RemoKa/DotFlipper/DotFlipper/DotFlipper.pdf

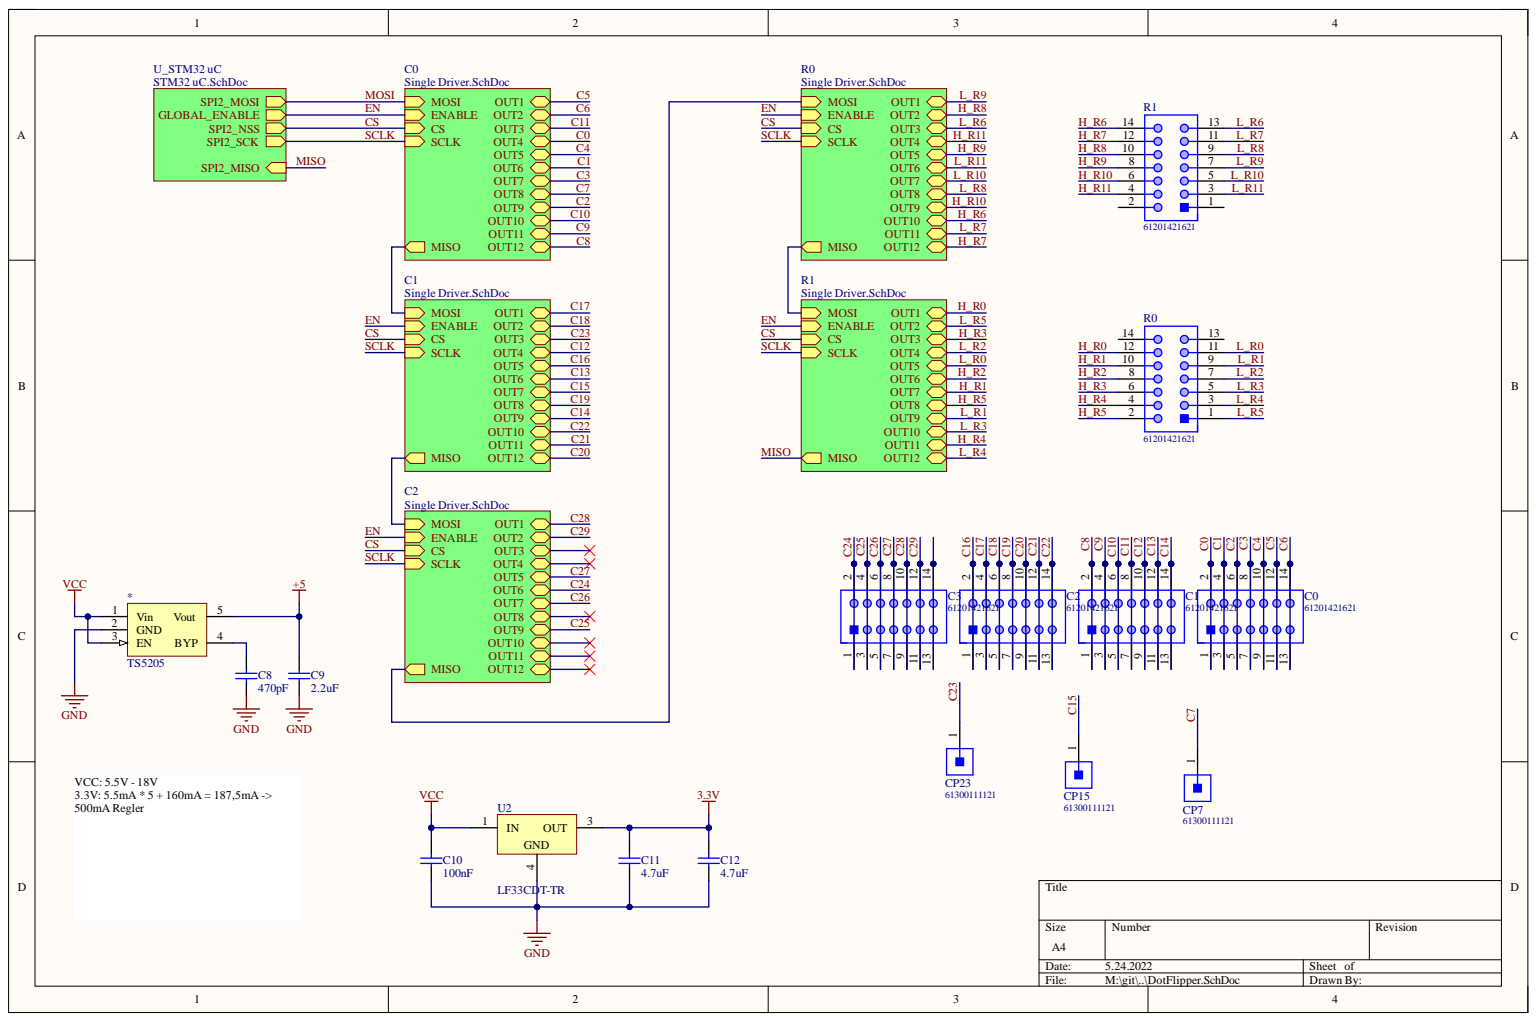
[picture p1: page 1]

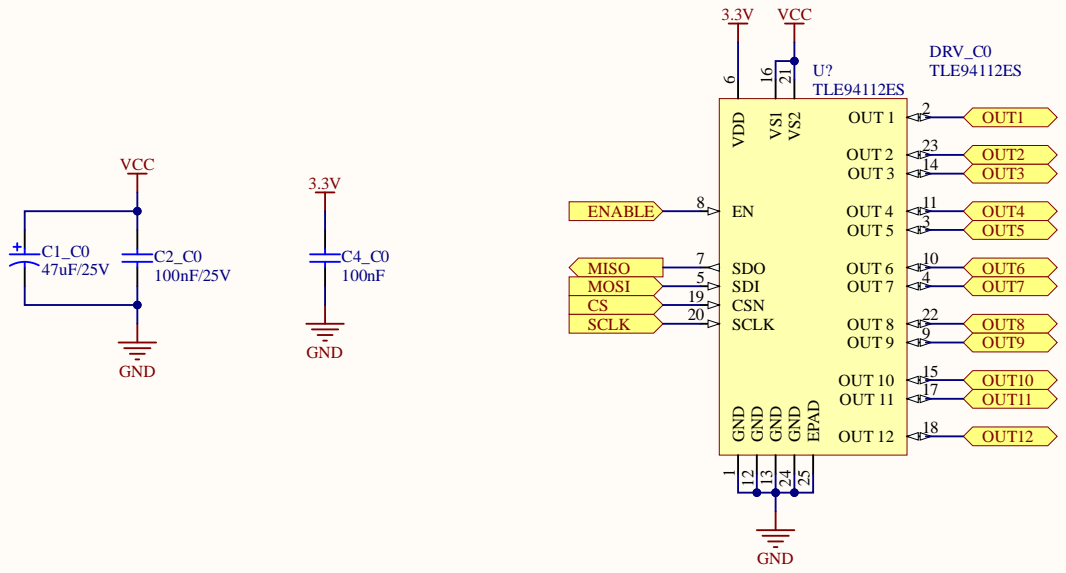
[picture p2: page 2]

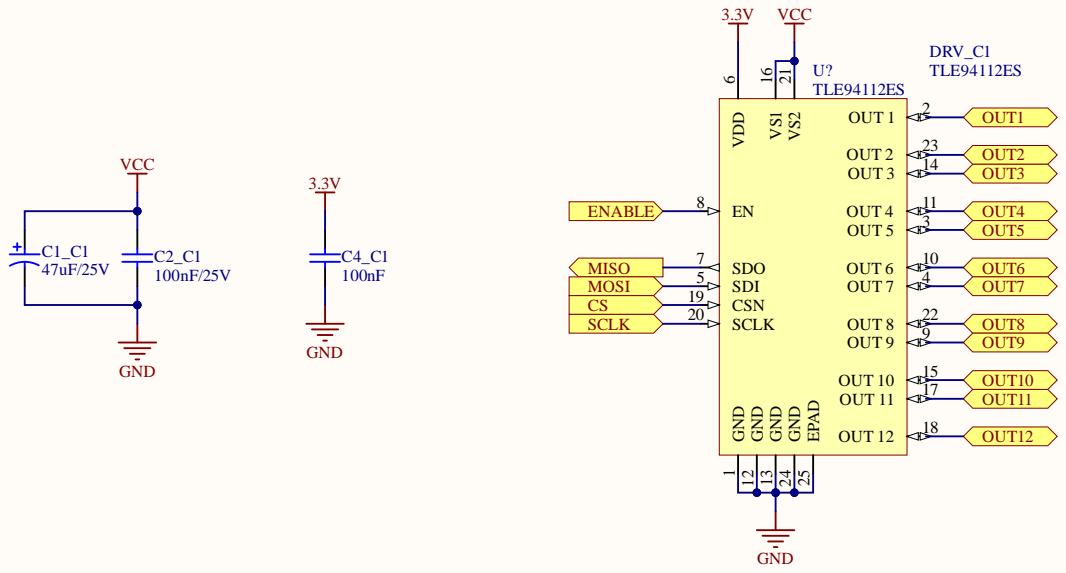
[picture p3: page 3]

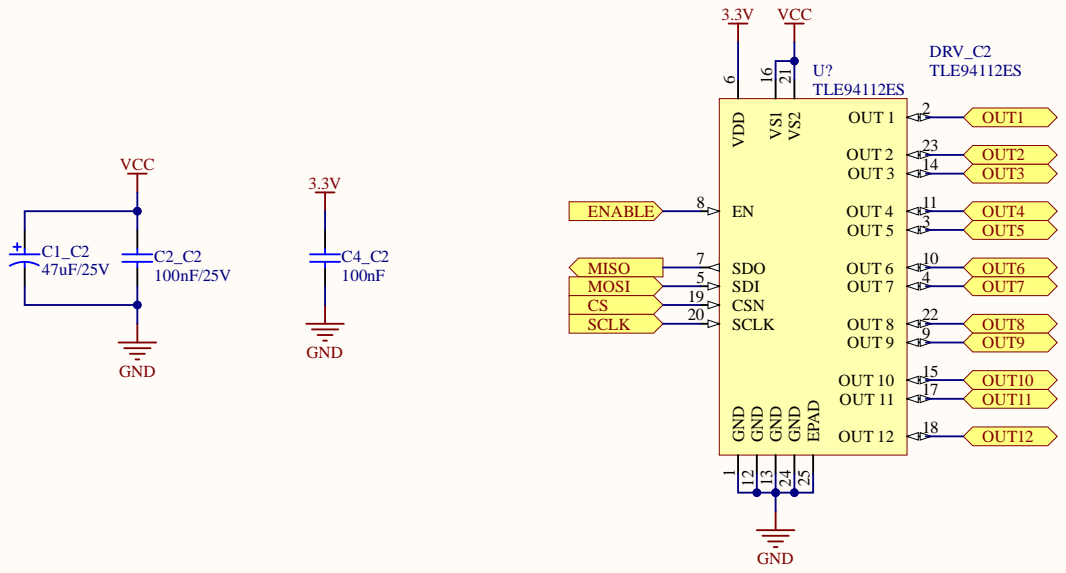
[picture p4: page 4]

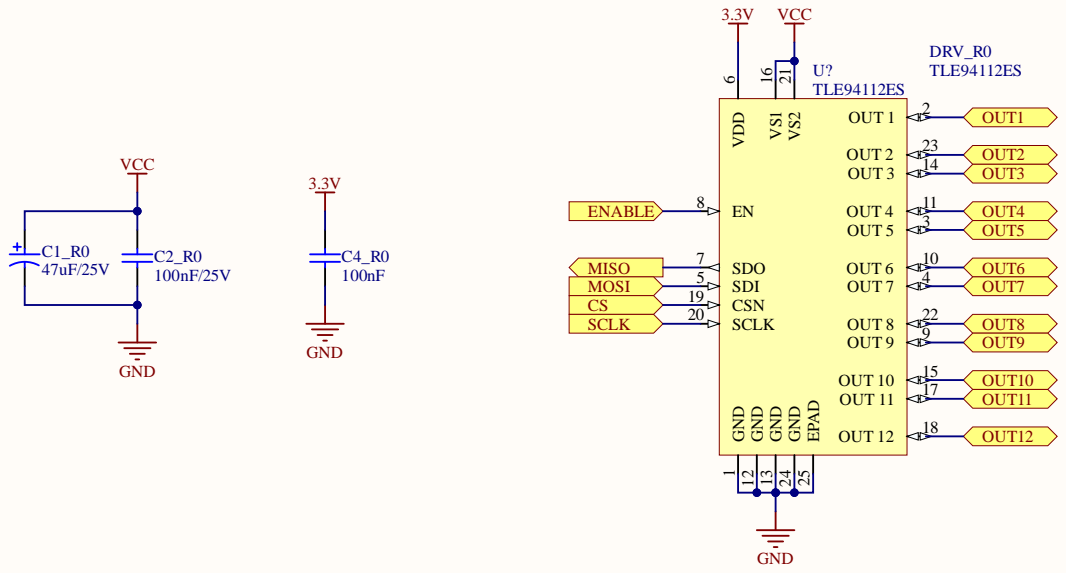
[picture p5: page 5]

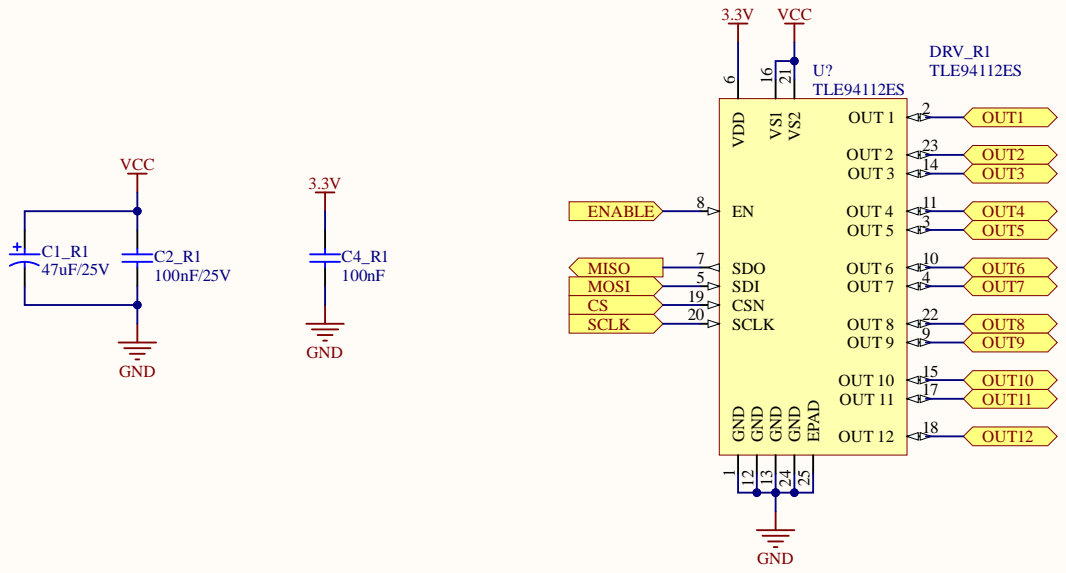
[picture p6: page 6]

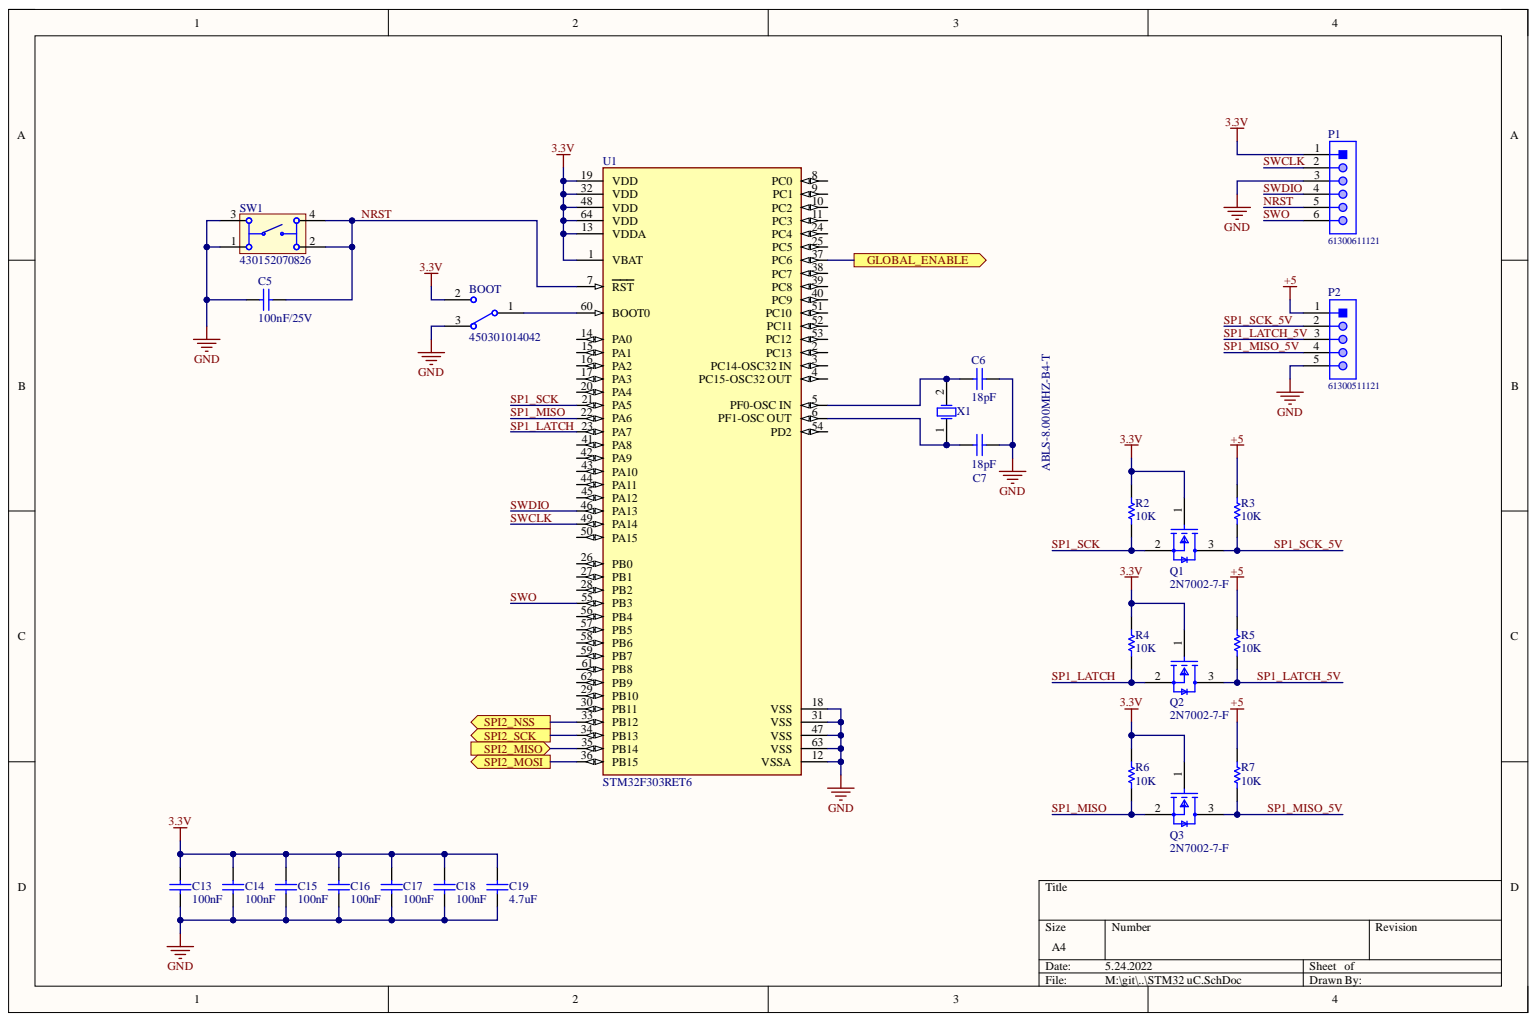
[picture p7: page 7]

4 8 | 1 0
6 4 | 1 1

5 4

3 1
4 7
6 3
1 2

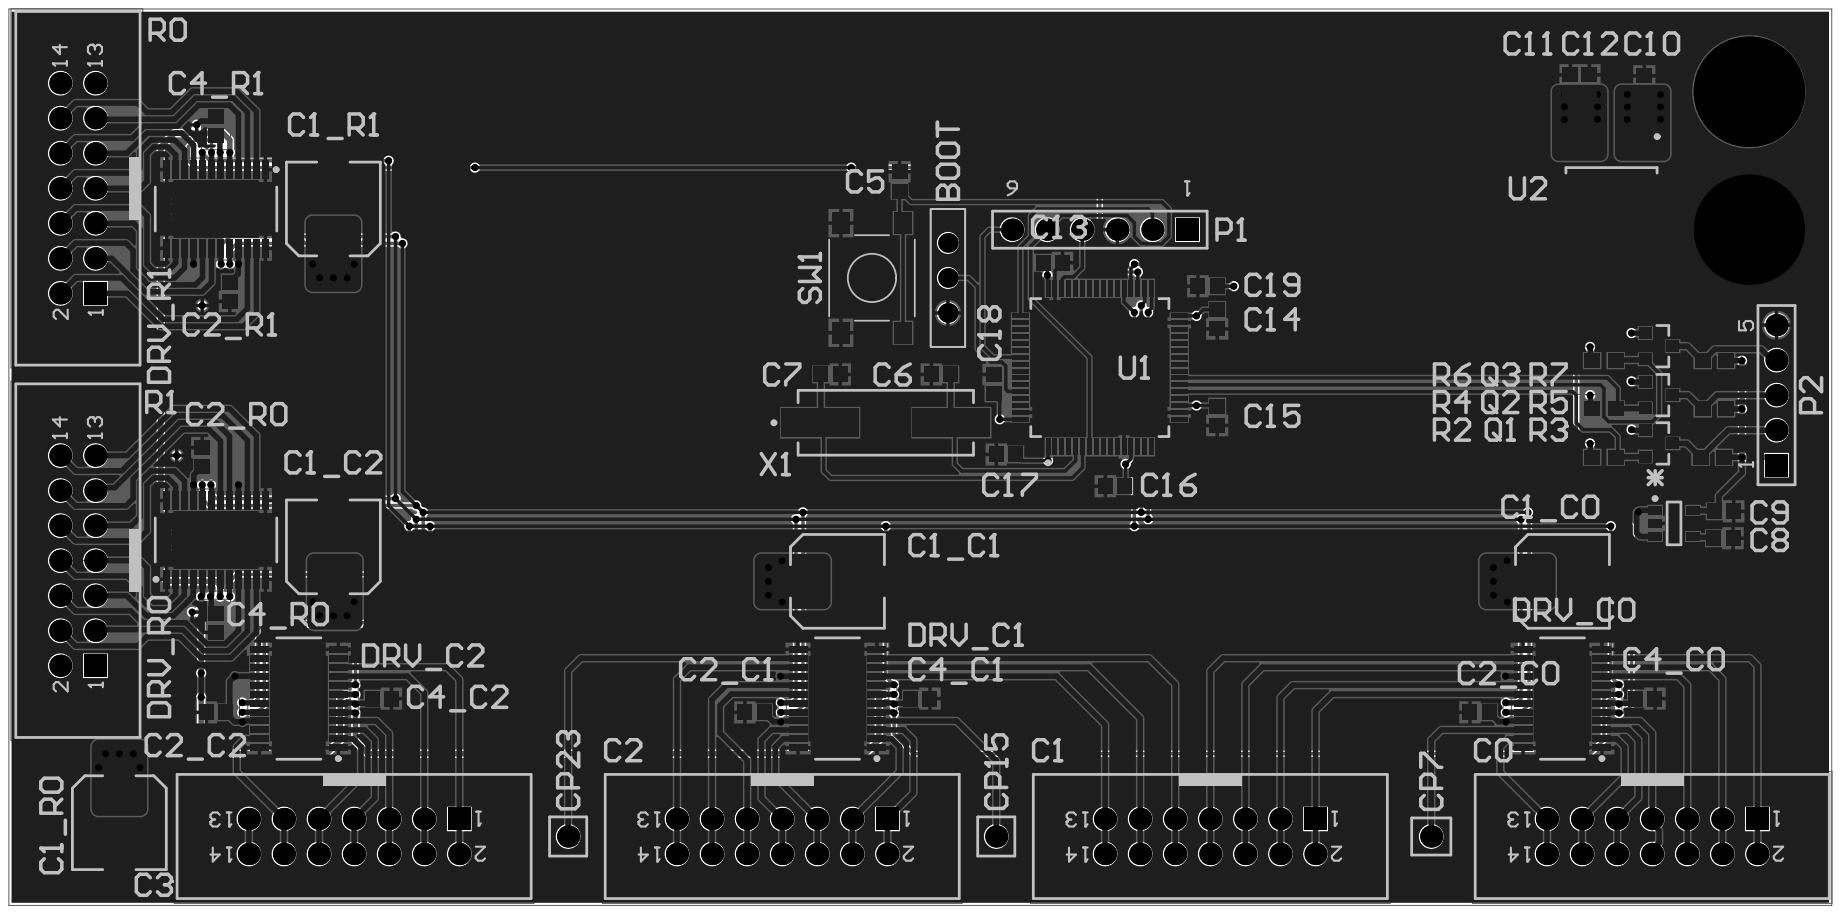
[picture p8: page 8]
