RemoKa/DotFlipper/Documentation/Driver.pdf

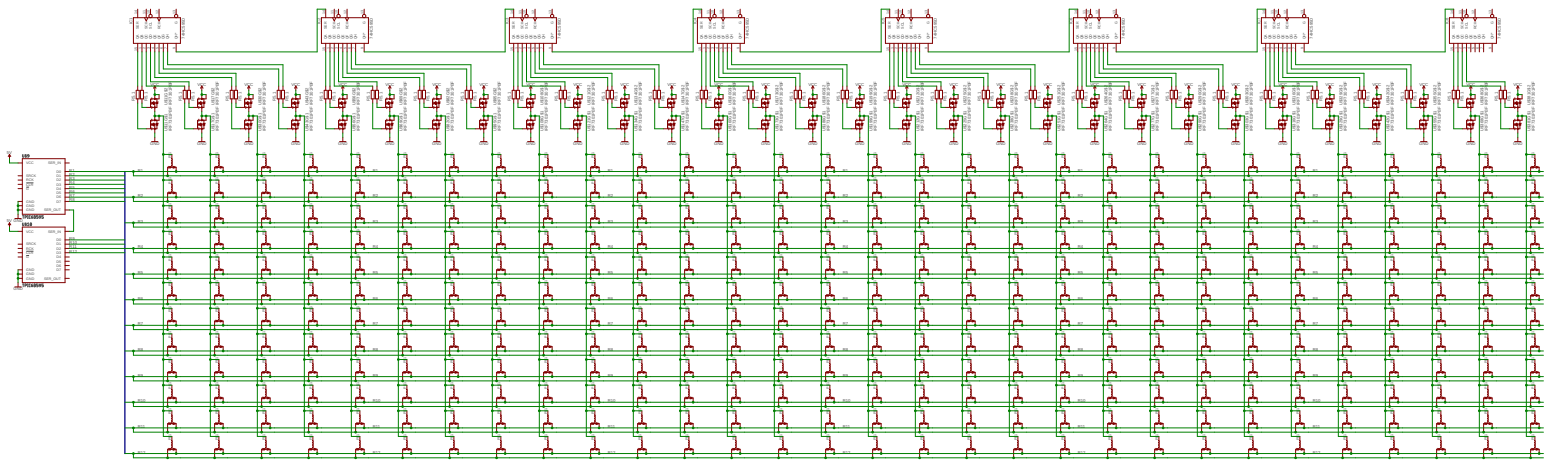
[picture p9: page 1]
