RemoKa/DotFlipper/(list of files, drawings)

Other design files:
DotFlipper/DotFlipper.PrjPcb
DotFlipper/DotFlipper.SchDoc
DotFlipper/PCB/DotFlipper.PcbDoc
DotFlipper/Single Driver.SchDoc
DotFlipper/STM32 uC.SchDoc
