RemoKa/DotFlipper/Firmware/DotFlipper/Core/Src/main.c

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
/* Includes ------------------------------------------------------------------*/
#include "main.h"
#include "spi.h"
#include "gpio.h"

/* USER CODE BEGIN Includes */
#include "TLE94112ES.h"
#include "DISPLAY.h"
/* USER CODE END Includes */

/* USER CODE BEGIN PD */
#define NO_OF_CHIPS	1
#define PULSELENGTH 1000
#define BUFFERLENGHT 12
#define DAISYCHAINLENGHT 5
/* USER CODE END PD */


/* USER CODE BEGIN PV */
int pause = 2000 - PULSELENGTH;
	//uint8_t TXBuf[NO_OF_CHIPS * 2];
	//uint8_t RXBuf[NO_OF_CHIPS * 2];
	//Message Messages[NO_OF_CHIPS];

	//uint8_t controllerData = 0;


///////////////////////////////////
	Display 	display;
	Matrix 		matrix;
	uint32_t 	framebuf1[BUFFERLENGHT];
	uint32_t 	framebuf2[BUFFERLENGHT];
	uint32_t 	difbuf[BUFFERLENGHT];
	Message		messages[DAISYCHAINLENGHT];

/* USER CODE END PV */

void SystemClock_Config(void);
/**
  * @brief  The application entry point.
  * @retval int
  */
int main(void)
{
  /* MCU Configuration--------------------------------------------------------*/

  /* Reset of all peripherals, Initializes the Flash interface and the Systick. */
  HAL_Init();

  /* Configure the system clock */
  SystemClock_Config();

  /* Initialize all configured peripherals */
  MX_GPIO_Init();
  MX_SPI2_Init();
  /* USER CODE BEGIN 2 */
  HAL_GPIO_WritePin(HB_EN_GPIO_Port, HB_EN_Pin, 1);

  matrix.width = 3;
  matrix.height = 2;
  matrix.DaisyChainLength = DAISYCHAINLENGHT;
  matrix.Messages = messages;

  display.width = 30;
  display.height = 12;
  display.Frontbuffer = framebuf1;
  display.Backbuffer = framebuf2;
  display.Differencebuffer = difbuf;
  display.Matrix = matrix;

  /* USER CODE END 2 */

  /* Infinite loop */
  /* USER CODE BEGIN WHILE */
  while (1)
  {
	  /*
	  	  Messages[0].RegisterAdress 	= HB_ACT_3_CTRL;
	  	  Messages[0].Data 				= HB10_HS_EN | HB11_LS_EN;
	  	  Messages[0].WriteClear 		= WRITE;

	  	  TLE94112ES_ConstructTXBuffer(TXBuf, NO_OF_CHIPS, Messages);
	  	  HAL_GPIO_WritePin(SPI2_CS_GPIO_Port, SPI2_CS_Pin, 0);
	  	  HAL_SPI_TransmitReceive(&hspi2, TXBuf, RXBuf, NO_OF_CHIPS * 2, HAL_MAX_DELAY);
	  	  HAL_GPIO_WritePin(SPI2_CS_GPIO_Port, SPI2_CS_Pin, 1);
	  	  TLE94112ES_DeconstructRXBuffer(RXBuf, NO_OF_CHIPS, Messages);

	  	  HAL_Delay(PULSELENGTH);

	  	  Messages[0].RegisterAdress 	= HB_ACT_3_CTRL;
	  	  Messages[0].Data 				= 0x00;
	  	  Messages[0].WriteClear 		= WRITE;

	  	  TLE94112ES_ConstructTXBuffer(TXBuf, NO_OF_CHIPS, Messages);
	  	  HAL_GPIO_WritePin(SPI2_CS_GPIO_Port, SPI2_CS_Pin, 0);
	  	  HAL_SPI_TransmitReceive(&hspi2, TXBuf, RXBuf, NO_OF_CHIPS * 2, HAL_MAX_DELAY);
	  	  HAL_GPIO_WritePin(SPI2_CS_GPIO_Port, SPI2_CS_Pin, 1);
	  	  TLE94112ES_DeconstructRXBuffer(RXBuf, NO_OF_CHIPS, Messages);

	  	  HAL_Delay(pause);

	  	  Messages[0].RegisterAdress 	= HB_ACT_3_CTRL;
	  	  Messages[0].Data 				= HB10_LS_EN | HB12_HS_EN;
	  	  Messages[0].WriteClear 		= WRITE;

	  	  TLE94112ES_ConstructTXBuffer(TXBuf, NO_OF_CHIPS, Messages);
	  	  HAL_GPIO_WritePin(SPI2_CS_GPIO_Port, SPI2_CS_Pin, 0);
	  	  HAL_SPI_TransmitReceive(&hspi2, TXBuf, RXBuf, NO_OF_CHIPS * 2, HAL_MAX_DELAY);
	  	  HAL_GPIO_WritePin(SPI2_CS_GPIO_Port, SPI2_CS_Pin, 1);
	  	  TLE94112ES_DeconstructRXBuffer(RXBuf, NO_OF_CHIPS, Messages);

	  	  HAL_Delay(PULSELENGTH);

	  	  Messages[0].RegisterAdress 	= HB_ACT_3_CTRL;
	  	  Messages[0].Data 				= 0x00;
	  	  Messages[0].WriteClear 		= WRITE;

	  	  TLE94112ES_ConstructTXBuffer(TXBuf, NO_OF_CHIPS, Messages);
	  	  HAL_GPIO_WritePin(SPI2_CS_GPIO_Port, SPI2_CS_Pin, 0);
	  	  HAL_SPI_TransmitReceive(&hspi2, TXBuf, RXBuf, NO_OF_CHIPS * 2, HAL_MAX_DELAY);
	  	  HAL_GPIO_WritePin(SPI2_CS_GPIO_Port, SPI2_CS_Pin, 1);
	  	  TLE94112ES_DeconstructRXBuffer(RXBuf, NO_OF_CHIPS, Messages);

	  	  HAL_Delay(pause);
	  	  */
    /* USER CODE END WHILE */

    /* USER CODE BEGIN 3 */
  }
  /* USER CODE END 3 */
}

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
