RemoKa/DotFlipper/Firmware/DotFlipper2/DotFlipper2.ioc

Mcu.UserName=STM32F303RETx
PA7.GPIO_Label=BLINK
PA7.Signal=GPIO_Output
PB12.GPIO_Label=SPI2_CS
PB12.Signal=GPIO_Output
PB13.Signal=SPI2_SCK
PB14.Signal=SPI2_MISO
PB15.Signal=SPI2_MOSI
PC6.GPIO_Label=HB_EN
PC6.Signal=GPIO_Output
PF0-OSC_IN.Signal=RCC_OSC_IN
PF1-OSC_OUT.Signal=RCC_OSC_OUT
