RemoKa/DotFlipper/Firmware/DotFlipper2/Core/Inc/main.h

#define BLINK_Pin GPIO_PIN_7
#define BLINK_GPIO_Port GPIOA
#define SPI2_CS_Pin GPIO_PIN_12
#define SPI2_CS_GPIO_Port GPIOB
#define HB_EN_Pin GPIO_PIN_6
#define HB_EN_GPIO_Port GPIOC
