RemoKa/DotFlipper/(commit log)

2021-09-17 Created PCB and Impoted Altium 2 Layer 1.6mm 1oz Rules and Stackup
    [DotFlipper.PrjPcb]
2021-09-17 Create Single Driver.SchDoc
    [Single Driver.SchDoc]
2021-09-17 added Top Level Sheet
    [DotFlipper.SchDoc]
2021-09-24 general base layout
    [DotFlipper.PcbDoc, DotFlipper.PrjPcb, DotFlipper.SchDoc, STM32 uC.SchDoc, Single Driver.SchDoc]
2021-09-24 functional SPI Protocol with baisc message functionality
2021-09-24 fixed text alignment
    [DotFlipper.SchDoc]
2021-09-24 Update STM32 uC.SchDoc
    added external components
    [STM32 uC.SchDoc]
2021-09-25 recreated PCB because of bug and placed connectors
    [DotFlipper.PcbDoc, DotFlipper.PrjPcb, DotFlipper.SchDoc, Single Driver.SchDoc]
2021-09-25 defined board shape
    [DotFlipper.PcbDoc]
2021-09-25 imporetd 4 Layer 1oz JLCPCB Stackup and Rules
    [DotFlipper.PcbDoc]
2021-09-25 assigned pins for Row Drivers
    [DotFlipper.PcbDoc]
2021-09-27 nes controller port
    [DotFlipper.PcbDoc, DotFlipper.SchDoc, STM32 uC.SchDoc]
2021-09-27 Added Level shifters
    [DotFlipper.PcbDoc, STM32 uC.SchDoc]
2021-09-28 created Column Connections and fixed errors and warning
    [DotFlipper.PcbDoc, DotFlipper.PrjPcb, DotFlipper.SchDoc, STM32 uC.SchDoc, Single Driver.SchDoc]
2021-09-28 updated Row Pinout and connector positions and routed power connections
    [DotFlipper.PcbDoc, DotFlipper.SchDoc, STM32 uC.SchDoc, Single Driver.SchDoc]
2021-09-28 defined power planes
    [DotFlipper.PcbDoc]
2021-10-03 more layout
    [DotFlipper.PcbDoc, Single Driver.SchDoc]
2021-10-12 implemented RXbuffer Deconstruction into Messages
    Messages can now Hold the Response and Global Status from the Chips. TLE94112ES_DeconstructRXBuffer() deconstrucs the buffer and puts the correct Response into the correct Message. It also handles Global Status
    [TLE94112ES.c, TLE94112ES.h, main.c]
2021-10-12 defined enum for button bitmasks
2021-10-12 fixed controller data type
    [main.c]
2021-10-12 added Flow Chart
2021-11-28 SPI Bus Layout
    [DotFlipper.PcbDoc]
2021-11-28 Basic uC Layout
    [DotFlipper.PcbDoc]
2021-11-28 tried to fix unrouted net constriants
    [DotFlipper.PcbDoc, Single Driver.SchDoc]
2021-11-28 saved previous changes
    [DotFlipper.PrjPcb]
2021-12-02 Fixed Layout issues
    [DotFlipper.PcbDoc]
2021-12-02 added STM32 DAtasheets
2021-12-02 added Voltage regulators
    [DotFlipper.SchDoc]
2021-12-02 Layout of Voltage Regulators and connect style of VCC
    [DotFlipper.PcbDoc]
2021-12-02 Finished Layout
    [DotFlipper.PcbDoc, DotFlipper.PrjPcb]
2021-12-04 added decoupling caps to stm32
    [DotFlipper.PcbDoc, DotFlipper.SchDoc, STM32 uC.SchDoc, Single Driver.SchDoc]
2021-12-04 silkscreen layout
    [DotFlipper.PcbDoc]
2021-12-04 generated gerbers
    [DotFlipper.PcbDoc, DotFlipper.PrjPcb]
2021-12-29 imported TLE Library and setup SPI2 Bus for TLE drivers
2021-12-29 Setup basic Abstraction Architechture
    Usercode only talks to Display-struct, which handles pixel-based requests and stores the framebufferes.
    Displays-truct only talks to Matrix, which handles hardware level requests from Display and stores information about physical layout of driver chips
    Matrix-struct uses Messages from TLE94112ES.h to talk to the hardware via SPI-Bus
2022-04-08 fixed includes and syntax error in header file
    [DISPLAY.h, main.c]
2022-05-24 created smart pdf using Viewer License
    [DotFlipper.PrjPcb]
2022-05-26 initialized pixel 0,0 with current datastructure
2022-05-26 updated Pin struct to use H-Bridge index insted of registers directly. Registers will need to bee looked up at runtime
2022-05-26 added enums for daisy chain and hbridge index for optional use to improve code readability
2022-06-04 basic implementation of flipping single pixel function
    [MATRIX.c]
2022-06-04 fixed old circular dependency
    [MATRIX.h, MATRIX_PIXEL_MAP.h]
