RemoKa/DotFlipper/(notices)

Notices in the files:
Firmware/DotFlipper/Core/Src/main.c:
Copyright (c) 2021 STMicroelectronics.
All rights reserved.
This software is licensed under terms that can be found in the LICENSE file
Firmware/DotFlipper2/Core/Inc/main.h:
Copyright (c) 2022 STMicroelectronics.
